rivques/mishap-d/README.md

Documentation lives [here](/docs/README.md).
