rivques/mishap-d/docs/README.md

# MISHAP-D Documentation
The documentation for MISHAP-D (the Marginally Intelligent System for High Altitude Payload Delivery) is split up among multiple files:
* [Bill of Materials](/docs/bill_of_materials.md)
* [Cargo Bay](/docs/CargoBayCAD.md)
* [Ground Station](/docs/Ground-Station-CAD.md)
* [Code](/docs/code.md)
* [Flight Tests](/docs/flight_tests.md)
* [Reflections](/docs/reflections.md)
* Initial planning: [Overall](/docs/PLANNING.md) and [Software](SOFTWAREPLANNING.md)
* [Weekly logs](/docs/WEEKLYLOG.md)
