rivques/mishap-d/docs/CargoBayCAD.md

# Cargobay Docs
## Basics
### Design purpose and success statement:
* This design intends to create a box that can connect to the bottom of a drone and hold the electronics for all of our various components and also hold the dropping cargo.
* This design is successful if: everything fits right without filing or scraping, all the components of the in-sky module can fit inside without interference, it is lightweight enough for the drone to comfortably move with good dexterity, and the cargo can be dropped at any time.
* If a picture is worth a thousand words then an STL is worth a million! Please click on the STL renderings to truly conceptualize my design choices!
* Make sure youre looking at the drop-down menus too!
  
### Timeline:

## Design
###  The box consists of three main components:
* The physical box (All laser cut)
* The add-ons (Hinges, Servo mount, and the hatch lock)
* The landing gear

## The Box
<details>
<summary>Trials and errors of the box </summary>

### The box went through two renditions plus a couple renovations.
[Originally the box looked like this:](https://github.com/rivques/mishap-d/blob/main/docs/STLFILES/boxtry1-try2.md)

### Box Label and Purposes:
 <div class="image-container">    
    <a href="https://github.com/rivques/mishap-d/edit/main/docs/CargoBayCAD.md">    
      GitHub    
    </a>

  </div>  
  
| Sign  |  Object and Intended Purpose | Photo |
| --- | --- | ---- |
| Circle  | This is the lidar, it measures the height of the box. The orientation is down, towards the ground  | lidar mount |
| Triangle  | Electronics bay door. The locks on the side are intended to lock it in place. It can't fall into the box or out of the box, therefore, stuck.  | SIDE ELECTRONICS DOOR |
| Pentagon | This is the bracket that Mr. Miller made, it is used to lock the electronics bay door and  very helpful for full assemblies because it locks a nut inside its jaws and prevents it from falling out. | bracket locking electronics bay door |
| Arrow | This is the release lock. It is a lock that is connected to a servo and when the servo moves the lock is released and the door can open and drop the payload. | servo lock |

The problems with this box:
* The door on the side is intended for access to the wires. When put together there wasn't enough space to do what it was designed for: Accessing the wires with the ability to change them around.
* There was no switch hole
* You couldn't access the USB port on the microprocessor without taking it out.
* The hinges were too tight on the bolt that held them in place, therefore they would be unable to open due to just gravity.
* The big hole on the side of the back wall is designed to be an opening for the SD card reader and writer and it was mismeasured
* The holes that were intended to screw into the hinges interfered with the box's brackets.
  
</details>

### Current box:

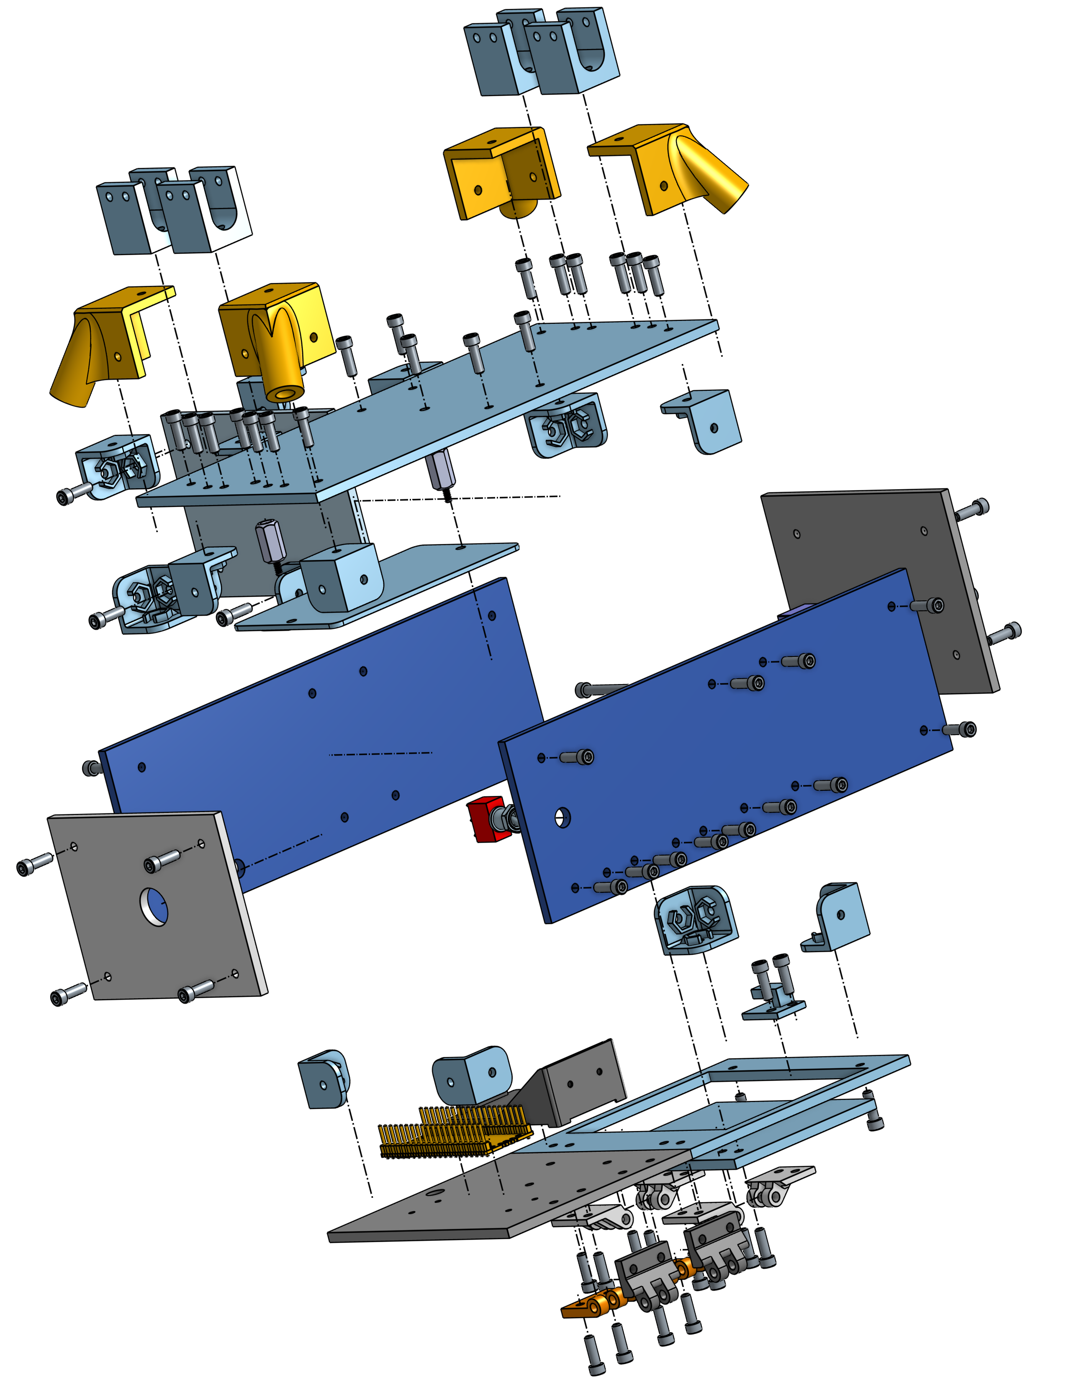
[picture p20: assets/Assembly 2.png]


* The laser-cut box is a two-section container with a center wall to prevent interference between the cargo and electronics.
* The electronics bay is comprised of a [] battery pack and a Raspberry Pico.
* The wholes on the box are sizes #4-40 for the lab's screws and #1-72 for the small ones
* The large hole on the electronics bay door is the lock. The point of the design is to be able to wrap a wire into the electronics bay side wall and twist it shut.
  <details>
  <summary>Photo Example</summary>
  <div class="image-container">    
    <a href="https://github.com/rivques/mishap-d/edit/main/docs/CargoBayCAD.md">    
      GitHub    
    </a>
  </div>  
  </details>

  ## Landing Gear
  
* The Landing gear only went through one rendition. To make them I used a plane and connected a tube to the end of a corner cap and used that same plane to connect to the entry slot.

[What it looks like](https://github.com/rivques/mishap-d/blob/main/docs/STLFILES/endcap.md)

[The entry slot](https://github.com/rivques/mishap-d/blob/main/docs/STLFILES/receiver.md)

* All together the landing gear doesn't fit a stick perfectly squared and horizontally, this is intentional. Intentional because of the tension forces provided giving a structural bonus of strength and tensile forces going everywhere. This does, however, cause the landing gear to explode if the drone falls out of the sky.
<details><summary>Imperfect fit</summary> 
 
landing gear imperfections
</details>
<details><summary>Bye Bye Landing Gear!</summary> 

landing gear bomb num.1

landing gear bomb num.2
</details>

## Addons
### Hinges!
opening doors
* There are two sets of hinges, one that goes on a wall-to-floor relationship and creates a 90-degree angle and one that has a floor-to-floor relationship with a 180-degree relationship.

| Catagory | 90 Degree Hinges | 180 Degree Hinges |
| --- | --- | --- |
| STL file view | [Wall-to-Floor](https://github.com/rivques/mishap-d/blob/main/docs/STLFILES/angled%20hinges.md) | [Floor-to-Floor](https://github.com/rivques/mishap-d/blob/main/docs/STLFILES/straight%20hinges.md) |
| Photo example |  |  |

### Servo Mount
* The servo mount was created because of my laziness, but it's the best thing to come out of this lab in years.
* The servo mount requires two holes in the wall and it wraps around the servo and tightens with a self-engraving bolt.
* It doesn't fall because the system is screwed in from the outside with a washer to ensure the screw applies pressure to the wall and the servo mount.
* The mount offers additional support to the servo by having a space for its screw holes, the platform is held in place by surrounding material.

  [Here be the STL](https://github.com/rivques/mishap-d/blob/main/docs/STLFILES/servo%20mount%20on%20wall.md)
  
| Top Right Profile | Section View Profile |
| ---- | ---- |
| front profile servo mount | side profile screw washer servo mount |

### Drone Mounts
* Very simple design intended to screw the Cargo Bay onto the drone
* Unfortunately, I had to make two renditions of this, the first one fit too perfectly and didn't take into account the screw threading. The screw threading embedded itself into the drone's landing gear.
* Make sure to open STLs, they don't auto-download to your computer and they will help you grasp what I'm trying to explain!
* Make sure to open the dropdown menus too! Some of them are for trials and errors, others are photos that would have been too big, and one is a very sad video.... the end of our project.
<details>
<summary>What are you talking about?</summary>
  
ScrewThreading

</details>

* Other than that, it worked great, used very little material, and could be printed without support.

[Rendered version of STL](https://github.com/rivques/mishap-d/blob/main/docs/STLFILES/drone%20mount.md)

### Cargo Bay Latch
* The cargo bay latch went through two renditions
* The second rendition wasn't made because there was anything wrong with the first, but because the design of the Cargo Bay Door changed and it was easier to remake it then edit the old one.
[stl rendering:](https://github.com/rivques/mishap-d/blob/main/docs/STLFILES/cargobayclip.md)

## What not to do!
* During construction, ensure the center door is oriented correctly to where the servo wires go through the premade hole.
* During wiring, don't forget to orient the pico and battery pack in a way where their wires and oriented closer to the hinges. This is because the door won't open all the way because of the wires, and if it does, then your wires are all broken.
* Before flying, MAKE SURE YOU DON'T MAKE THE LANDING GEAR TOO BIG. IT CAUSED OUR DRONE TO CRASH!!!!!!
  
<details>
<summary>Graham, I don't believe you for a second.</summary>

https://github.com/rivques/mishap-d/assets/38469076/972d8c86-7016-41f2-878d-53066bbe97b3
  
</details>

## Wiring
The cargo bay wiring was prototyped on a breadboard but was transferred to a protoboard for rigidity. Below is the actual wiring of the board (our original plan is [here](/payload-circuit.fzz))
* 9V into ESP32 VIN and input leg of voltage regulator
* Servo: Power -> ESP32 VIN, GND -> GND, Signal -> ESP32 D27
* MPL3115A2 (altimeter): MPL SDA -> ESP32 D21, MPL SCL -> ESP32 D22, GND -> GND, MPL VIN -> voltage regulator output
* Raspberry Pi Pico: ESP32 TX2-> Pico GP9, GND -> GND, and Pico VSYS -> voltage regulator output
* Debug LED: Cathode -> GND, Anode -> ESP32 D32
* Voltage regulator: 33µF cap across GND and VIN, 0.1µF cap across GND and VOUT
