rivques/mishap-d/docs/ground-station-pin-table.md

## LoRa
LoRa | ESP32 GPIO # | ESP32 pin label
---|---|---
VIN|3V3|3V3
GND|GND|GND
G0|2|D2
SCK|18|D18
MISO|19|D19
MOSI|23|D23
CS|4|D4
RST|16|RX2
## OLED
OLED | ESP32 GPIO # | ESP32 pin label
---|---|---
Vin|3V3|3V3
Gnd|GND|GND
Rst|27|D27
Clk|22|D22
Data|21|D21
## Rotary encoder
Encoder | ESP32 GPIO # | ESP32 pin label
---|---|---
+|3V3|3V3
GND|GND|GND
CLK|35|D35
DT|33|D33
SW|32|D32
## Potentiometers
Theta | ESP32 GPIO # | ESP32 pin label
---|---|---
1|3V3|3V3
3|GND|GND
2|25|D25
Phi | ESP32 GPIO # | ESP32 pin label
---|---|---
1|3V3|3V3
3|GND|GND
2|26|D26
## LEDs
LED 1 | ESP32 GPIO # | ESP32 pin label
---|---|---
-|GND|GND
+|13|D13
LED 2 | ESP32 GPIO # | ESP32 pin label
---|---|---
-|GND|GND
+|12|D12
## Pushbuttons
Trigger/back | ESP32 GPIO # | ESP32 pin label
---|---|---
1|GND|GND
2|5|D5
Face/aim correct | ESP32 GPIO # | ESP32 pin label
---|---|---
1|GND|GND
2|34|D34
## Power
9V negative -> ESP32 GND
9V positive -> power switch -> ESP32 VIN
