rivques/mishap-d/assets/f0211503-800px-wm.jpg

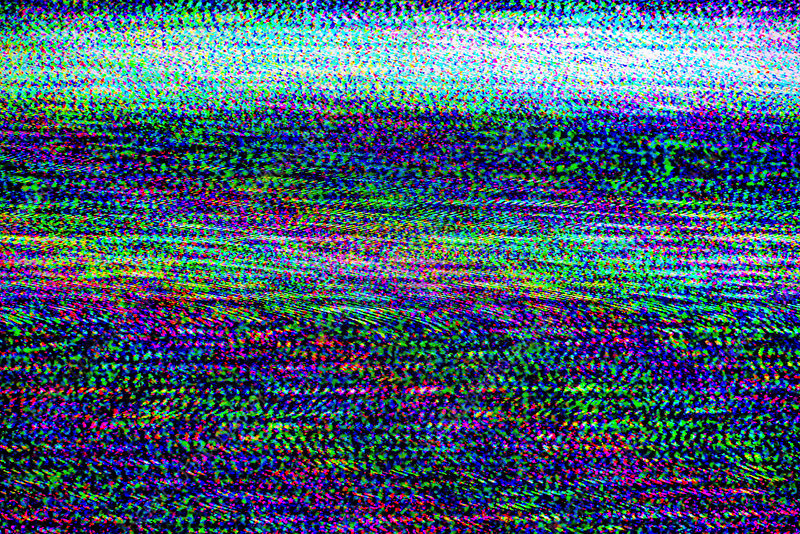
assets/f0211503-800px-wm.jpg
