rivques/mishap-d/assets/image12.png

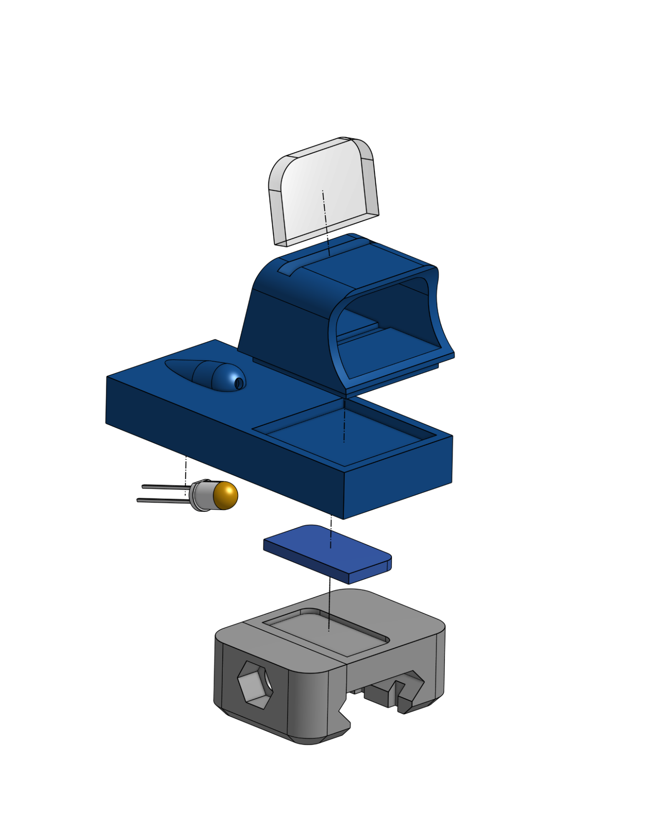
assets/image12.png
