rivques/mishap-d/assets/image14.png

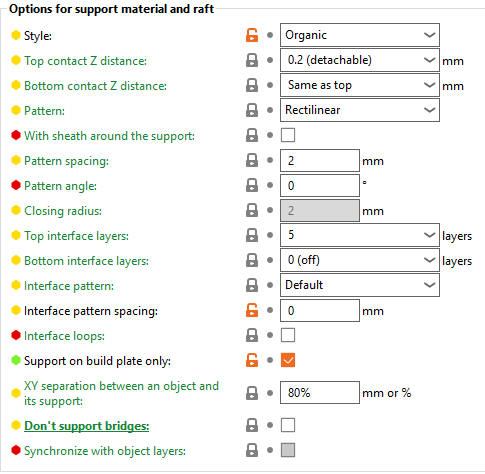
assets/image14.png
