rivques/mishap-d/assets/system-diagram.png

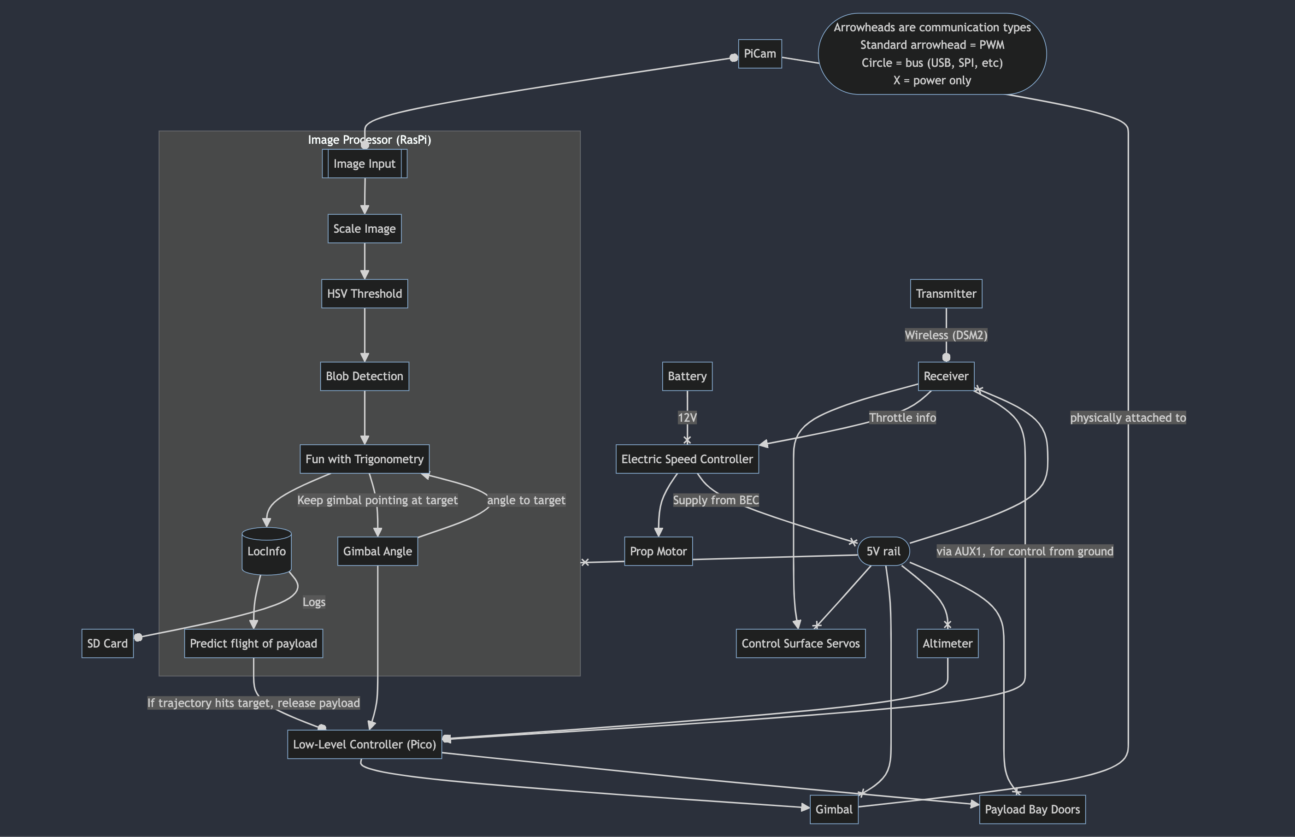
assets/system-diagram.png
