rivques/mishap-d/Assembly 2.step

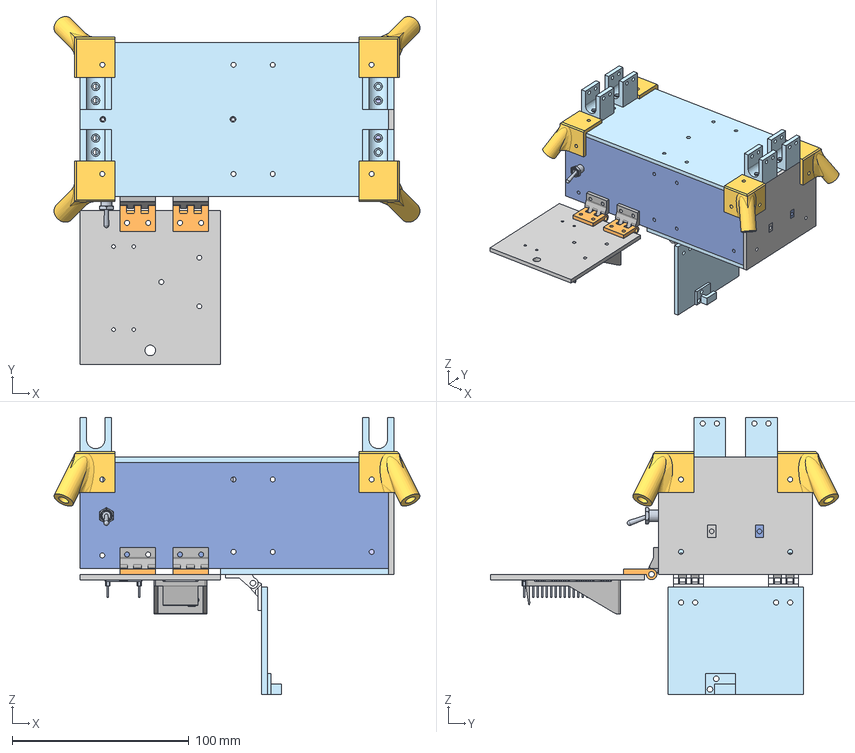
[picture p25: CAD file, 2024-05-09]
Assembly 2.step
207.2 x 197.1 x 157.1 mm
25x.5 Aluminum Hex Male Female Standoff x 2
Micro Servo 180 SG92R
bracket x 14
Micro Servo Horn Single Arm
servo retainer right
PICO_MURATA.STEP_1
PICO_HEADER_HOLES x 43
PICO_MURATA.STEP
PICO_BOURNS.STEP
PICO_PIN_HEADERS x 42
PICO_REF_ONSEMI.STEP
PICO_REF_LED.STEP
PICO_REF_MICROCONTROLLER.STEP
PICO_REF_SWITCH.STEP
PICO_REF_USB.STEP x 5
PICO_REF_BOARD.STEP
PICO_DIODES.STEP
PICO_RICHTEK.STEP
PICO_AEL.STEP
id659
id664
servo retainer left
