rivques/mishap-d/(list of files, drawings)

Other design files:
ground-station-circuit.fzz
payload-circuit.fzz
