rivques/mishap-d/tests/lidar_test/lidar_test.ino

/*------------------------------------------------------------------------------

  LIDARLite Arduino Library
  v4LED/v4LED

  This example shows methods for running the LIDAR-Lite v4 LED in various
  modes of operation. To exercise the examples open a serial terminal
  program (or the Serial Monitor in the Arduino IDE) and send ASCII
  characters to trigger the commands. See "loop" function for details.

  *** NOTE ***
  The LIDAR-Lite v4 LED is strictly a 3.3V system. The Arduino Due is a
  3.3V system and is recommended for use with the LIDAR-Lite v4 LED.
  Care MUST be taken if connecting to a 5V system such as the Arduino Uno.
  See comment block in the setup() function for details on I2C connections.
  It is recommended to use a voltage level-shifter if connecting the GPIO
  pins to any 5V system I/O.

  Connections:
  LIDAR-Lite 5 VDC   (pin 1) to Arduino 5V
  LIDAR-Lite Ground  (pin 2) to Arduino GND
  LIDAR-Lite I2C SDA (pin 3) to Arduino SDA
  LIDAR-Lite I2C SCL (pin 4) to Arduino SCL

  Optional connections to utilize GPIO triggering:
  LIDAR-Lite GPIOA   (pin 5) to Arduino Digital 2
  LIDAR-Lite GPIOB   (pin 6) to Arduino Digital 3

  (Capacitor recommended to mitigate inrush current when device is enabled)
  680uF capacitor (+) to Arduino 5V
  680uF capacitor (-) to Arduino GND

  See the Operation Manual for wiring diagrams and more information

------------------------------------------------------------------------------*/

#include <stdint.h>
#include <Wire.h>
#include "LIDARLite_v4LED.h"

LIDARLite_v4LED myLidarLite;

#define FAST_I2C

#define MonitorPin    3
#define TriggerPin    2

enum rangeType_T
{
    RANGE_NONE,
    RANGE_SINGLE,
    RANGE_CONTINUOUS,
    RANGE_SINGLE_GPIO,
    RANGE_CONTINUOUS_GPIO
};

void setup()
{
    // Initialize Arduino serial port (for display of ASCII output to PC)
    Serial.begin(115200);

    // Initialize Arduino I2C (for communication to LidarLite)
    Wire.begin();
    #ifdef FAST_I2C
        #if ARDUINO >= 157
            Wire.setClock(400000UL); // Set I2C frequency to 400kHz (for Arduino Due)
        #else
            TWBR = ((F_CPU / 400000UL) - 16) / 2; // Set I2C frequency to 400kHz
        #endif
    #endif

    // ----------------------------------------------------------------------
    // The LIDAR-Lite v4 LED is strictly a 3.3V system. The Arduino Due is a
    // 3.3V system and is recommended for use with the LIDAR-Lite v4 LED.
    // Care MUST be taken if connecting to a 5V system such as the Arduino Uno.
    //
    // I2C is a two wire communications bus that requires a pull-up resistor
    // on each signal. In the Arduino microcontrollers the Wire.begin()
    // function (called above) turns on pull-up resistors that pull the I2C
    // signals up to the system voltage rail. The Arduino Uno is a 5V system
    // and using the Uno's internal pull-ups risks damage to the LLv4.
    //
    // The two digitalWrite() functions (below) turn off the micro's internal
    // pull-up resistors. This protects the LLv4 from damage via overvoltage
    // but requires external pullups to 3.3V for the I2C signals.
    //
    // External pull-ups are NOT present on the Arduino Uno and must be added
    // manually to the I2C signals. 3.3V is available on pin 2 of the 6pin
    // "POWER" connector and can be used for this purpose. See the Uno
    // schematic for details:
    // https://www.arduino.cc/en/uploads/Main/arduino-uno-schematic.pdf
    //
    // External 1.5k ohm pull-ups to 3.3V are already present on the
    // Arduino Due. If using the Due no further action is required
    // ----------------------------------------------------------------------
    digitalWrite(SCL, LOW);
    digitalWrite(SDA, LOW);

    // ----------------------------------------------------------------------
    // Optional GPIO pin assignments for measurement triggering & monitoring
    // ----------------------------------------------------------------------
    pinMode(MonitorPin, INPUT);
    pinMode(TriggerPin, OUTPUT);
    digitalWrite(TriggerPin, LOW);

    // ----------------------------------------------------------------------
    // Optionally configure the LidarLite parameters to lend itself to
    // various modes of operation by altering 'configure' input integer.
    // See LIDARLite_v4LED.cpp for details.
    // ----------------------------------------------------------------------
    myLidarLite.configure(0);
}


void loop()
{
    uint16_t distance;
    uint8_t  newDistance;
    uint8_t  inputChar;
    rangeType_T rangeMode = RANGE_CONTINUOUS;

    MenuPrint();

    // Continuous loop
    while (1)
    {
        //Serial.println("loop");
        //===================================================================
        // 1) Each time through the loop, look for a serial input character
        //===================================================================
        if (Serial.available())
        {
            Serial.print("Serial available: ");
            //  read input character ...
            inputChar = (uint8_t) Serial.read();
            Serial.println(inputChar);

            // ... and parse
            switch (inputChar)
            {
                case '1':
                    rangeMode = RANGE_SINGLE;
                    break;

                case '2':
                    rangeMode = RANGE_CONTINUOUS;
                    Serial.println("rangeMode = RANGE_CONTINUOUS");
                    break;

                case '3':
                    rangeMode = RANGE_SINGLE_GPIO;
                    break;

                case '4':
                    rangeMode = RANGE_CONTINUOUS_GPIO;
                    break;

                case '5':
                    rangeMode = RANGE_NONE;
                    dumpCorrelationRecord();
                    break;

                case '.':
                    rangeMode = RANGE_NONE;
                    break;

                case 'v':
                case 'V':
                    rangeMode = RANGE_NONE;
                    VersionPrint();
                    break;

                case ' ':
                case 0x0D:
                case 0x0A:
                    MenuPrint();
                    rangeMode = RANGE_NONE;
                    break;

                default:
                    rangeMode = RANGE_NONE;
                    break;
            }
        }

        //===================================================================
        // 2) Check on mode and operate accordingly
        //===================================================================
        switch (rangeMode)
        {
            case RANGE_NONE:
                newDistance = 0;
                break;

            case RANGE_SINGLE:
                newDistance = distanceSingle(&distance);
                rangeMode   = RANGE_NONE;
                break;

            case RANGE_CONTINUOUS:
                newDistance = distanceContinuous(&distance);
                break;

            case RANGE_SINGLE_GPIO:
                newDistance = distanceSingleGpio(&distance);
                rangeMode   = RANGE_NONE;
                break;

            case RANGE_CONTINUOUS_GPIO:
                newDistance = distanceContinuousGpio(&distance);
                break;

            default:
                newDistance = 0;
                rangeMode   = RANGE_NONE;
                break;
        }

        //===================================================================
        // 3) When there is new distance data, print it to the serial port
        //===================================================================
        if (newDistance)
        {
            Serial.println(distance);
        }
    }
}

//---------------------------------------------------------------------
// Menu Print
//---------------------------------------------------------------------
void MenuPrint(void)
{
    Serial.println("");
    Serial.println("============================================");
    Serial.println("== LLv4 - Type a single character command ==");
    Serial.println("============================================");
    Serial.println(" 1 - Single Measurement");
    Serial.println(" 2 - Continuous Measurement");
    Serial.println(" 3 - Single Measurement using trigger / monitor pins");
    Serial.println(" 4 - Continuous Measurement using trigger / monitor pins");
    Serial.println(" 5 - Dump Correlation Record");
    Serial.println(" . - Stop Measurement");
    Serial.println(" V - Print Version Numbers");
    Serial.println("");
}

//---------------------------------------------------------------------
// Read Single Distance Measurement
//
// This is the simplest form of taking a measurement. This is a
// blocking function as it will not return until a range has been
// taken and a new distance measurement can be read.
//---------------------------------------------------------------------
uint8_t distanceSingle(uint16_t * distance)
{
    // 1. Trigger range measurement.
    myLidarLite.takeRange();

    // 2. Wait for busyFlag to indicate device is idle.
    myLidarLite.waitForBusy();

    // 3. Read new distance data from device registers
    *distance = myLidarLite.readDistance();

    return 1;
}

//---------------------------------------------------------------------
// Read Single Distance Measurement using Trigger / Monitor Pins
//
// This is the simplest form of taking a measurement. This is a
// blocking function as it will not return until a range has been
// taken and a new distance measurement can be read. Instead of using
// the STATUS register to poll for BUSY, this function uses a
// GPIO pin on the LIDAR-Lite to monitor the BUSY flag.
//---------------------------------------------------------------------
uint8_t distanceSingleGpio(uint16_t * distance)
{
    // 1. Trigger range measurement.
    myLidarLite.takeRangeGpio(TriggerPin, MonitorPin);

    // 2. Wait for busyFlag to indicate device is idle.
    myLidarLite.waitForBusyGpio(MonitorPin);

    // 3. Read new distance data from device registers
    *distance = myLidarLite.readDistance();

    return 1;
}

//---------------------------------------------------------------------
// Read Continuous Distance Measurements
//
// The most recent distance measurement can always be read from
// device registers. Polling for the BUSY flag in the STATUS
// register can alert the user that the distance measurement is new
// and that the next measurement can be initiated. If the device is
// BUSY this function does nothing and returns 0. If the device is
// NOT BUSY this function triggers the next measurement, reads the
// distance data from the previous measurement, and returns 1.
//---------------------------------------------------------------------
uint8_t distanceContinuous(uint16_t * distance)
{
   //Serial.println("distanceContinuous");
    uint8_t newDistance = 0;

    // Check on busyFlag to indicate if device is idle
    // (meaning = it finished the previously triggered measurement)
    if (myLidarLite.getBusyFlag() == 0)
    {
        //Serial.println("distanceContinuous: not busy");
        // Trigger the next range measurement
        myLidarLite.takeRange();

        // Read new distance data from device registers
        *distance = myLidarLite.readDistance();
        Serial.println(*distance);

        // Report to calling function that we have new data
        newDistance = 1;
    } else {
        //Serial.println("distanceContinuous: busy");
    }

    return newDistance;
}

//---------------------------------------------------------------------
// Read Continuous Distance Measurements using Trigger / Monitor Pins
//
// The most recent distance measurement can always be read from
// device registers. Polling for the BUSY flag using the Monitor Pin
// can alert the user that the distance measurement is new
// and that the next measurement can be initiated. If the device is
// BUSY this function does nothing and returns 0. If the device is
// NOT BUSY this function triggers the next measurement, reads the
// distance data from the previous measurement, and returns 1.
//---------------------------------------------------------------------
uint8_t distanceContinuousGpio(uint16_t * distance)
{
    uint8_t newDistance = 0;

    // Check on busyFlag to indicate if device is idle
    // (meaning = it finished the previously triggered measurement)
    if (myLidarLite.getBusyFlagGpio(MonitorPin) == 0)
    {
        // Trigger the next range measurement
        myLidarLite.takeRangeGpio(TriggerPin, MonitorPin);

        // Read new distance data from device registers
        *distance = myLidarLite.readDistance();

        // Report to calling function that we have new data
        newDistance = 1;
    }

    return newDistance;
}

//---------------------------------------------------------------------
// Print the correlation record for analysis
//---------------------------------------------------------------------
void dumpCorrelationRecord()
{
    int16_t corrValues[192];
    uint8_t i;

    myLidarLite.correlationRecordRead(corrValues);

    for (i=0 ; i<192 ; i++)
    {
        Serial.print(corrValues[i], DEC);
        Serial.print(",");
    }
    Serial.println(" ");
}

//---------------------------------------------------------------------
void VersionPrint(void)
//---------------------------------------------------------------------
{
    uint8_t    dataBytes[12];
    uint8_t  * nrfVerString;
    uint16_t * lrfVersion;
    uint8_t  * hwVersion;
    uint8_t  i;

    //===========================================
    // Print nRF Software Version
    //===========================================
    myLidarLite.read(0x30, dataBytes, 11, 0x62);
    nrfVerString = dataBytes;
    Serial.print("nRF Software Version  - ");
    for (i=0 ; i<11 ; i++)
    {
      Serial.write(nrfVerString[i]);
    }
    Serial.println("");

    //===========================================
    // Print LRF Firmware Version
    //===========================================
    myLidarLite.read(0x72, dataBytes, 2, 0x62);
    lrfVersion = (uint16_t *) dataBytes;
    Serial.print("LRF Firmware Version  - v");
    Serial.print((*lrfVersion) / 100);
    Serial.print(".");
    Serial.print((*lrfVersion) % 100);
    Serial.println("");

    //===========================================
    // Print Hardware Version
    //===========================================
    myLidarLite.read(0xE1, dataBytes, 1, 0x62);
    hwVersion = dataBytes;
    Serial.print("Hardware Version      - ");
    switch (*hwVersion)
    {
        case 16 : Serial.println("RevA"); break;
        case  8 : Serial.println("RevB"); break;
        default : Serial.println("????"); break;
    }
}
