rivques/mishap-d/tests/basic_radio_client/basic_radio_client.ino

// Feather9x_TX
// -*- mode: C++ -*-
// Example sketch showing how to create a simple messaging client (transmitter)
// with the RH_RF95 class. RH_RF95 class does not provide for addressing or
// reliability, so you should only use RH_RF95 if you do not need the higher
// level messaging abilities.
// It is designed to work with the other example Feather9x_RX

#include <SPI.h>
#include <RH_RF95.h>

#include <RHReliableDatagram.h>
 
#define GROUND_LORA_ADDR 1
#define PAYLOAD_LORA_ADDR 2

// First 3 here are boards w/radio BUILT-IN. Boards using FeatherWing follow.
#define RFM95_CS    4
#define RFM95_INT   2
#define RFM95_RST   16


/* Some other possible setups include:

// Feather 32u4:
#define RFM95_CS   8
#define RFM95_RST  4
#define RFM95_INT  7

// Feather M0:
#define RFM95_CS   8
#define RFM95_RST  4
#define RFM95_INT  3

// Arduino shield:
#define RFM95_CS  10
#define RFM95_RST  9
#define RFM95_INT  7

// Feather 32u4 w/wing:
#define RFM95_RST 11  // "A"
#define RFM95_CS  10  // "B"
#define RFM95_INT  2  // "SDA" (only SDA/SCL/RX/TX have IRQ!)

// Feather m0 w/wing:
#define RFM95_RST 11  // "A"
#define RFM95_CS  10  // "B"
#define RFM95_INT  6  // "D"
*/

// Change to 434.0 or other frequency, must match RX's freq!
#define RF95_FREQ 915.0

// Singleton instance of the radio driver
RH_RF95 driver(RFM95_CS, RFM95_INT);
RHReliableDatagram manager(driver, GROUND_LORA_ADDR);

void setup() {
  pinMode(RFM95_RST, OUTPUT);
  digitalWrite(RFM95_RST, HIGH);

  Serial.begin(115200);
  while (!Serial) delay(1);
  delay(100);

  Serial.println("Feather LoRa TX Test!");

  // manual reset
  digitalWrite(RFM95_RST, LOW);
  delay(10);
  digitalWrite(RFM95_RST, HIGH);
  delay(10);
  
  while (!manager.init()) {
    Serial.println("LoRa radio init failed");
    Serial.println("Uncomment '#define SERIAL_DEBUG' in RH_RF95.cpp for detailed debug info");
    while (1);
  }
  Serial.println("LoRa radio init OK!");
  // Defaults after init are 434.0MHz, modulation GFSK_Rb250Fd250, +13dbM
  if (!driver.setFrequency(RF95_FREQ)) {
    Serial.println("setFrequency failed");
    while (1);
  }
  Serial.print("Set Freq to: "); Serial.println(RF95_FREQ);

  // Defaults after init are 434.0MHz, 13dBm, Bw = 125 kHz, Cr = 4/5, Sf = 128chips/symbol, CRC on

  // The default transmitter power is 13dBm, using PA_BOOST.
  // If you are using RFM95/96/97/98 modules which uses the PA_BOOST transmitter pin, then
  // you can set transmitter powers from 5 to 23 dBm:
  driver.setTxPower(23, false);
}

int16_t packetnum = 0;  // packet counter, we increment per xmission

 
uint8_t data[] = "Hello World!";
// Dont put this on the stack:
uint8_t buf[RH_RF95_MAX_MESSAGE_LEN];
 
void loop()
{
  Serial.println("Sending to rf95_reliable_datagram_server");
    
  // Send a message to manager_server
  if (manager.sendtoWait(data, sizeof(data), PAYLOAD_LORA_ADDR))
  {
    // Now wait for a reply from the server
    uint8_t len = sizeof(buf);
    uint8_t from;   
    if (manager.recvfromAckTimeout(buf, &len, 2000, &from))
    {
      Serial.print("got reply from : 0x");
      Serial.print(from, HEX);
      Serial.print(": ");
      Serial.println((char*)buf);
    }
    else
    {
      Serial.println("No reply, is rf95_reliable_datagram_server running?");
    }
  }
  else
    Serial.println("sendtoWait failed");
  delay(500);
}
 
