rivques/mishap-d/(commit log)

2023-10-31 rename flowchart
2023-12-06 add physics sim to flowchart
2023-12-26 Switch from using vision to using lasers for localization
2024-02-21 actually what if we just used one thread
2024-02-29 fix velocity, add telemetry, restructure config, and begin adding servo
    [config.h, mishap-d.ino, payloadcontroller.h]
2024-03-07 fix typo in interface demo
    [graham-interface.ino]
2024-03-13 integrate lidar and tweak menu code
2024-03-18 add payload circuit
    [payload-circuit.fzz]
2024-03-20 update circuit
    [payload-circuit.fzz]
2024-04-10 add debug led and payload only mode
2024-04-11 tweaks to led logic
2024-04-12 tweak servo angles
2024-04-17 add ground-station-circuit
    [ground-station-circuit.fzz]
2024-04-17 add ground-station-pin-table
2024-04-19 tweaks to payload release height and servo angles
2024-05-03 fix a dumb pin bug
    [config.h, payloadcontroller.h]
2024-05-03 work on getting pico logging working
2024-05-08 pivot to altimeter + logging on pico
2024-05-09 add servoasssistant
2024-05-22 Create angled hinges.md
2024-05-22 Create straight hinges.md
2024-05-22 Update straight hinges.md
2024-05-24 Create servo mount on wall.md
2024-05-24 add wiring
2024-05-24 Create drone mount.md
2024-05-24 add BOM
2024-05-26 CAD docs
